icl-rocketry/Ricardo-JollyRoger/Hardware/Ricardo-JollyRoger.kicad_pcb

## KiCad design Hardware/Ricardo-JollyRoger.kicad_pcb (2025-02-01)

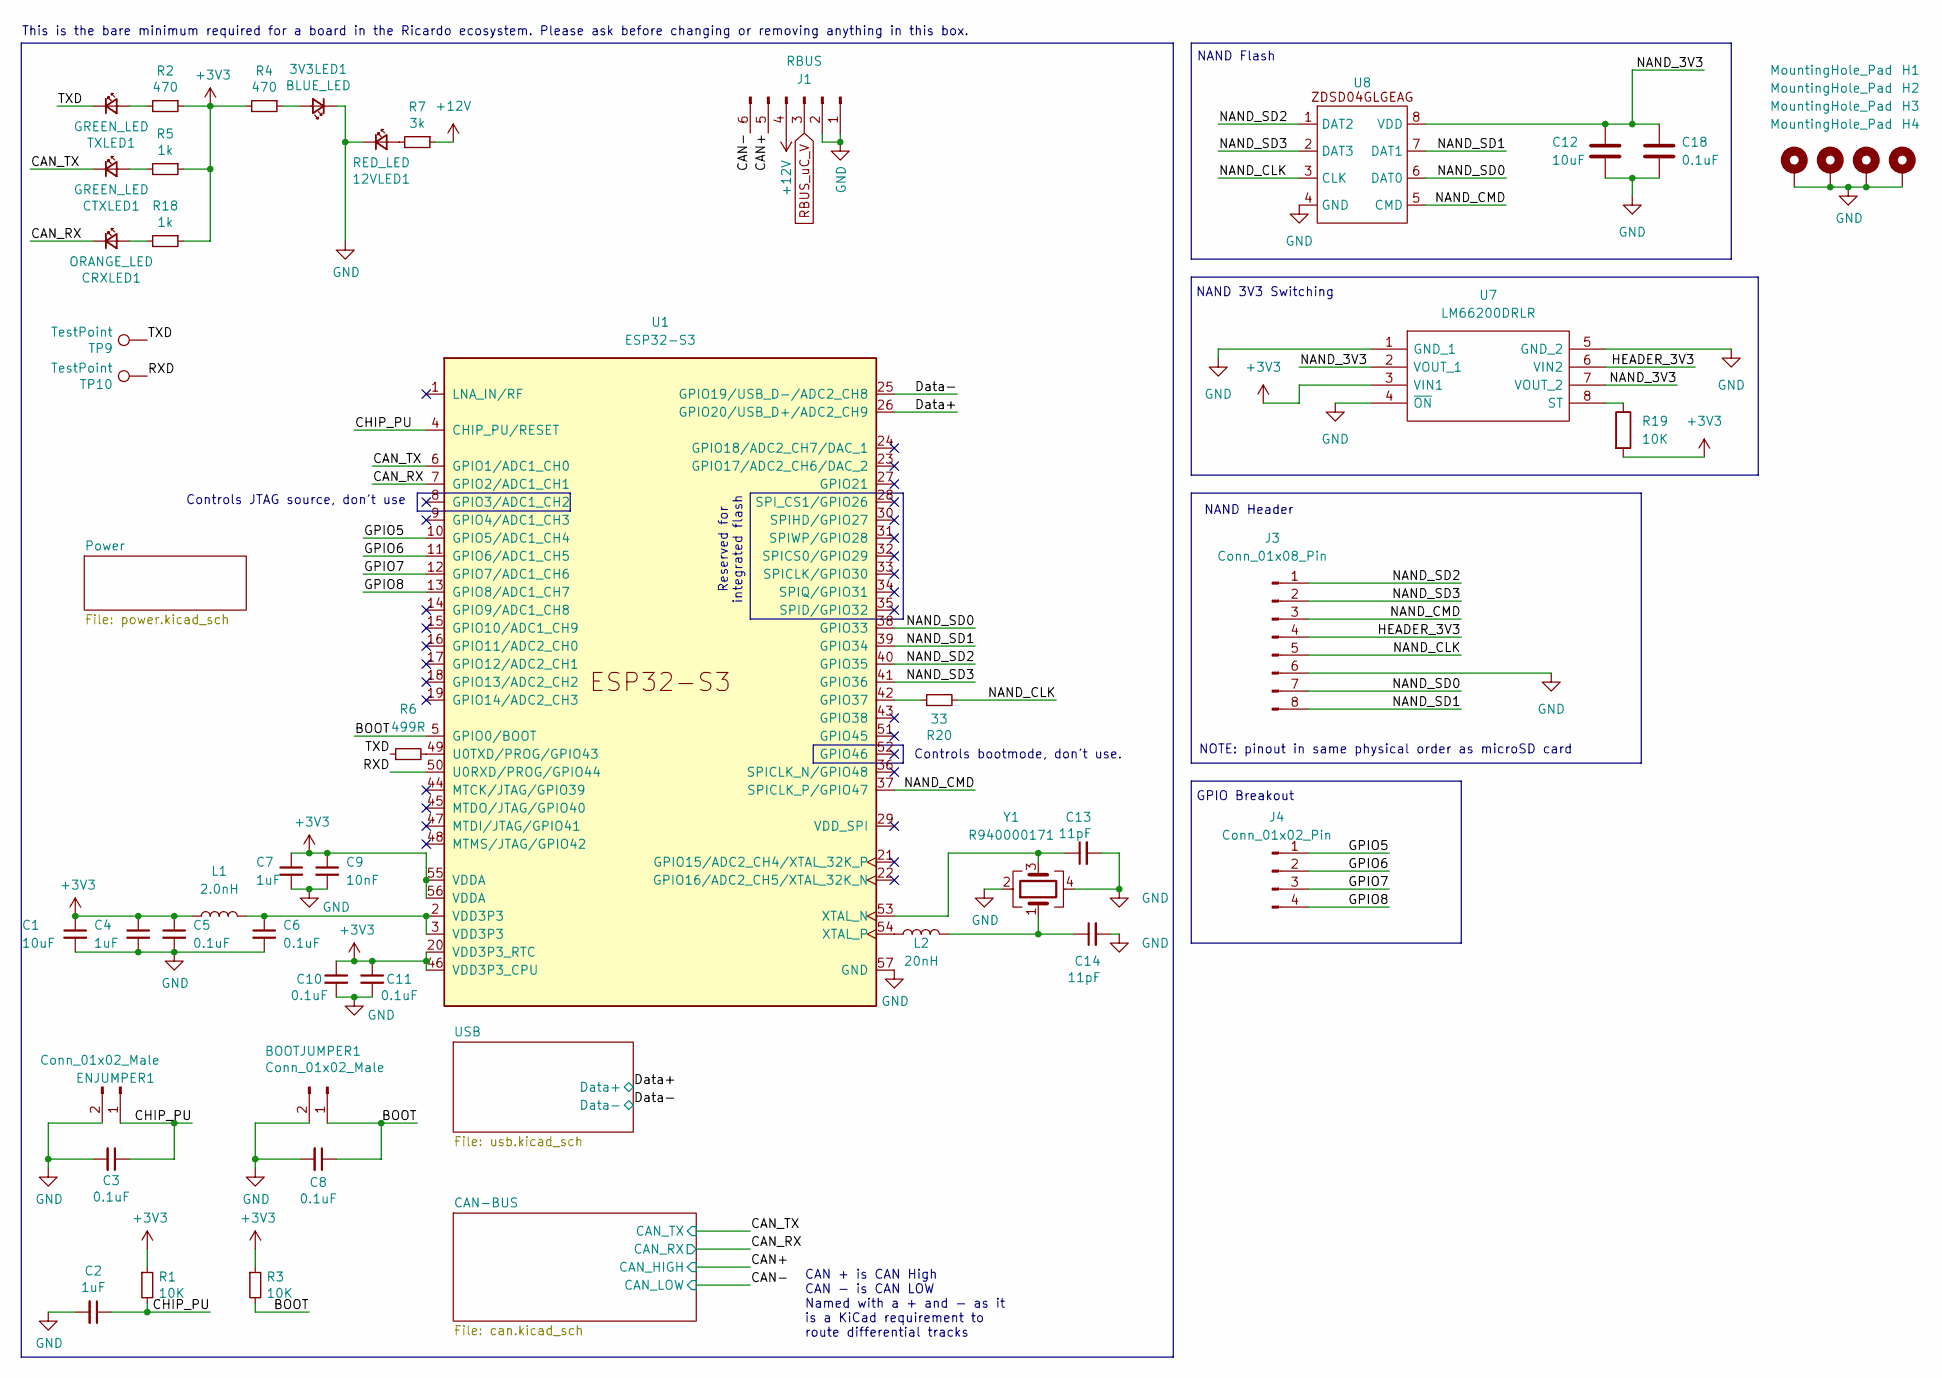
[picture p1: schematic Ricardo-JollyRoger.kicad_sch]

Parts:
3V3LED1: BLUE_LED; LED_0402_1005Metric
12VLED1: RED_LED; LED_0402_1005Metric
BOOTJUMPER1: Conn_01x02_Male; PinHeader_1x02_P2.54mm_Vertical
C1, C12: 10uF; C_0402_1005Metric
C2, C4, C7: 1uF; C_0402_1005Metric
C3, C5, C6, C8, C10, C11, C18: 0.1uF; C_0402_1005Metric
C9: 10nF; C_0402_1005Metric
C13, C14: 11pF; C_0402_1005Metric
CRXLED1: ORANGE_LED; LED_0402_1005Metric
CTXLED1: GREEN_LED; LED_0402_1005Metric
ENJUMPER1: Conn_01x02_Male; PinHeader_1x02_P2.54mm_Vertical
H1, H2, H3, H4: MountingHole_Pad; MountingHole_3.2mm_M3_DIN965_Pad
J1: RBUS; Molex_Mini-Fit_Jr_5566-06A_2x03_P4.20mm_Vertical
J3: Conn_01x08_Pin; Molex_Pico-Clasp_202396-0807_1x08-1MP_P1.00mm_Horizontal
J4: Conn_01x02_Pin; Molex_Pico-Clasp_202396-0407_1x04-1MP_P1.00mm_Horizontal
L1: 2.0nH; L_0402_1005Metric
L2: 20nH; L_0402_1005Metric
R1, R3, R19: 10K; R_0402_1005Metric
R2, R4: 470; R_0402_1005Metric
R5, R18: 1k; R_0402_1005Metric
R6: 499R; R_0402_1005Metric
R7: 3k; R_0402_1005Metric
R20: 33; R_0402_1005Metric
TP9, TP10: TestPoint; TestPoint_Pad_D1.0mm
TXLED1: GREEN_LED; LED_0402_1005Metric
U1: ESP32-S3; QFN40P700X700X90-57N
U7: LM66200DRLR; SOTFL50P160X60-8N; Manufacturer_Part_Number LM66200DRLR; Mouser Part Number 595-LM66200DRLR
U8: LGA-8_8x6mm_P1.27mm
Y1: R940000171; Crystal_SMD_2016-4Pin_2.0x1.6mm

Connections:
+3V3: C1.1, C4.1, C5.1, C7.1, C9.1, C10.1, C11.1, L1.1, R1.1, R2.1, R3.1, R4.2, R5.1, R18.1, R19.2, U1.20 (VDD3P3_RTC), U1.46 (VDD3P3_CPU), U1.55 (VDDA), U1.56 (VDDA), U7.3 (VIN1); also elsewhere on the board
+12V: J1.4, R7.1
/BOOT: BOOTJUMPER1.1, C8.1, R3.2, U1.5 (GPIO0/BOOT)
/CAN+: J1.5; also elsewhere on the board
/CAN-: J1.6; also elsewhere on the board
/CAN_RX: CRXLED1.1 (K), U1.7 (GPIO2/ADC1_CH1); also elsewhere on the board
/CAN_TX: CTXLED1.1 (K), U1.6 (GPIO1/ADC1_CH0); also elsewhere on the board
/CHIP_PU: C2.1, C3.1, ENJUMPER1.1, R1.2, U1.4 (CHIP_PU/RESET)
/Data+: U1.26 (GPIO20/USB_D+/ADC2_CH9); also elsewhere on the board
/Data-: U1.25 (GPIO19/USB_D-/ADC2_CH8); also elsewhere on the board
/GPIO5: J4.1, U1.10 (GPIO5/ADC1_CH4)
/GPIO6: J4.2, U1.11 (GPIO6/ADC1_CH5)
/GPIO7: J4.3, U1.12 (GPIO7/ADC1_CH6)
/GPIO8: J4.4, U1.13 (GPIO8/ADC1_CH7)
/HEADER_3V3: J3.4, U7.6 (VIN2)
/NAND_3V3: C12.1, C18.1, U7.2 (VOUT_1), U7.7 (VOUT_2), U8.8 (VDD)
/NAND_CLK: J3.5, R20.2, U8.3 (CLK)
/NAND_CMD: J3.3, U1.37 (SPICLK_P/GPIO47), U8.5 (CMD)
/NAND_SD0: J3.7, U1.38 (GPIO33), U8.6 (DAT0)
/NAND_SD1: J3.8, U1.39 (GPIO34), U8.7 (DAT1)
/NAND_SD2: J3.1, U1.40 (GPIO35), U8.1 (DAT2)
/NAND_SD3: J3.2, U1.41 (GPIO36), U8.2 (DAT3)
/RXD: TP10.1, U1.50 (U0RXD/PROG/GPIO44)
/TXD: R6.1, TP9.1, TXLED1.1 (K)
GND: 3V3LED1.1 (K), 12VLED1.1 (K), BOOTJUMPER1.2, C1.2, C2.2, C3.2, C4.2, C5.2, C6.2, C7.2, C8.2, C9.2, C10.2, C11.2, C12.2, C13.2, C14.2, C18.2, ENJUMPER1.2, H1.1, H2.1, H3.1, H4.1, J1.1, J1.2, J3.6, U1.57 (GND), U7.1 (GND_1), U7.4 (~ON), U7.5 (GND_2), U8.4 (GND), Y1.2, Y1.4; also elsewhere on the board
unnamed: 3V3LED1.2 (A), R4.1
unnamed: 12VLED1.2 (A), R7.2
unnamed: C6.1, L1.2, U1.2 (VDD3P3), U1.3 (VDD3P3)
unnamed: C14.1, L2.2, Y1.1
unnamed: CRXLED1.2 (A), R18.2
unnamed: CTXLED1.2 (A), R5.2
unnamed: R2.2, TXLED1.2 (A)
unnamed: R20.1, U1.42 (GPIO37)
unnamed: R6.2, U1.49 (U0TXD/PROG/GPIO43)
unnamed: C13.1, U1.53 (XTAL_N), Y1.3
unnamed: L2.1, U1.54 (XTAL_P)
unnamed: R19.1, U7.8 (ST)
RBUS_uC_V: J1.3; also elsewhere on the board

Notes on the sheet:
Controls bootmode, don't use.
NAND Flash
This is the bare minimum required for a board in the Ricardo ecosystem. Please ask before changing or removing anything in this box.
CAN + is CAN High CAN - is CAN LOW Named with a + and - as it is a KiCad requirement to route differential tracks
NOTE: pinout in same physical order as microSD card
NAND 3V3 Switching
GPIO Breakout
Controls JTAG source, don't use
Reserved for integrated flash
NAND Header

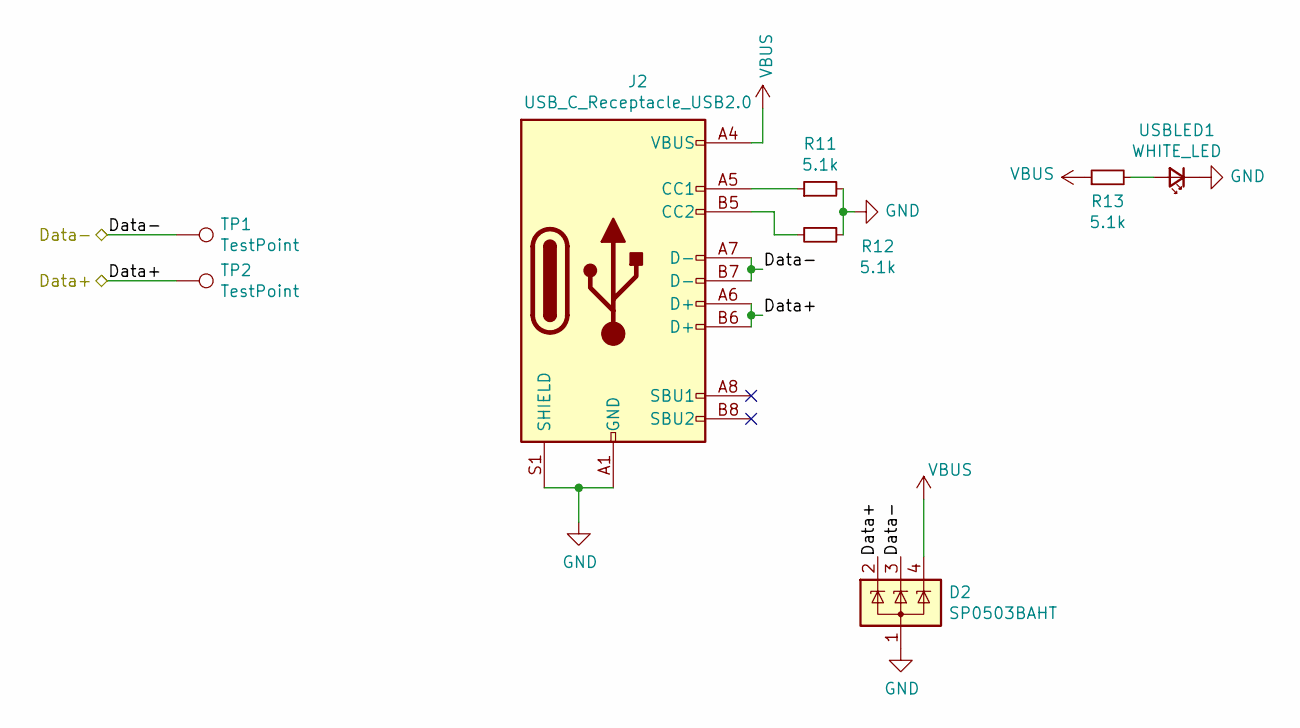
[picture p2: schematic usb.kicad_sch]

Parts:
D2: SP0503BAHT; SOT-143
J2: USB_C_Receptacle_USB2.0; USB_C_Receptacle_Palconn_UTC16-G
R11, R12, R13: 5.1k; R_0402_1005Metric
TP1, TP2: TestPoint; TestPoint_Pad_D1.0mm
USBLED1: WHITE_LED; LED_0402_1005Metric

Connections:
/Data+: D2.2 (K), J2.A6 (D+), J2.B6 (D+), TP2.1; also elsewhere on the board
/Data-: D2.3 (K), J2.A7 (D-), J2.B7 (D-), TP1.1; also elsewhere on the board
GND: D2.1 (A), J2.A1 (GND), J2.A12 (GND), J2.B1 (GND), J2.B12 (GND), J2.S1 (SHIELD), R11.2, R12.1, USBLED1.1 (K); also elsewhere on the board
unnamed: J2.A5 (CC1), R11.1
unnamed: J2.B5 (CC2), R12.2
unnamed: R13.2, USBLED1.2 (A)
VBUS: D2.4 (K), J2.A4 (VBUS), J2.A9 (VBUS), J2.B4 (VBUS), J2.B9 (VBUS), R13.1; also elsewhere on the board

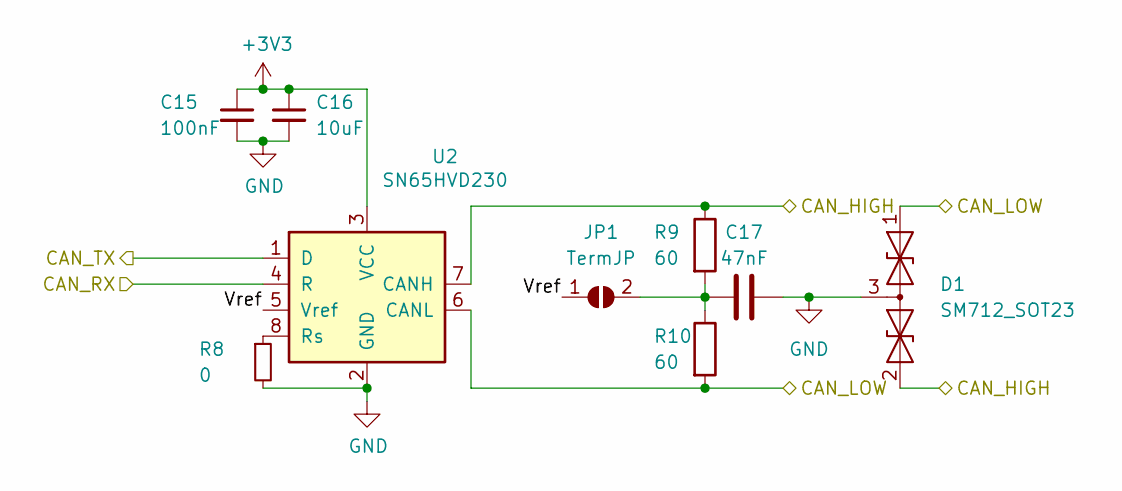
[picture p3: schematic can.kicad_sch]

Parts:
C15: 100nF; C_0402_1005Metric
C16: 10uF; C_0402_1005Metric
C17: 47nF; C_0402_1005Metric
D1: SM712_SOT23; SOT-23
JP1: TermJP; SolderJumper-2_P1.3mm_Open_RoundedPad1.0x1.5mm
R8: 0; R_0402_1005Metric
R9, R10: 60; R_0603_1608Metric
U2: SN65HVD230; SOIC-8_3.9x4.9mm_P1.27mm

Connections:
+3V3: C15.1, C16.1, U2.3 (VCC); also elsewhere on the board
/CAN+: D1.2 (A2), R9.1, U2.7 (CANH); also elsewhere on the board
/CAN-: D1.1 (A1), R10.2, U2.6 (CANL); also elsewhere on the board
/CAN-BUS/Vref: JP1.1 (A), U2.5 (Vref)
/CAN_RX: U2.4 (R); also elsewhere on the board
/CAN_TX: U2.1 (D); also elsewhere on the board
GND: C15.2, C16.2, C17.2, D1.3 (common), R8.2, U2.2 (GND); also elsewhere on the board
unnamed: C17.1, JP1.2 (B), R9.2, R10.1
unnamed: R8.1, U2.8 (Rs)

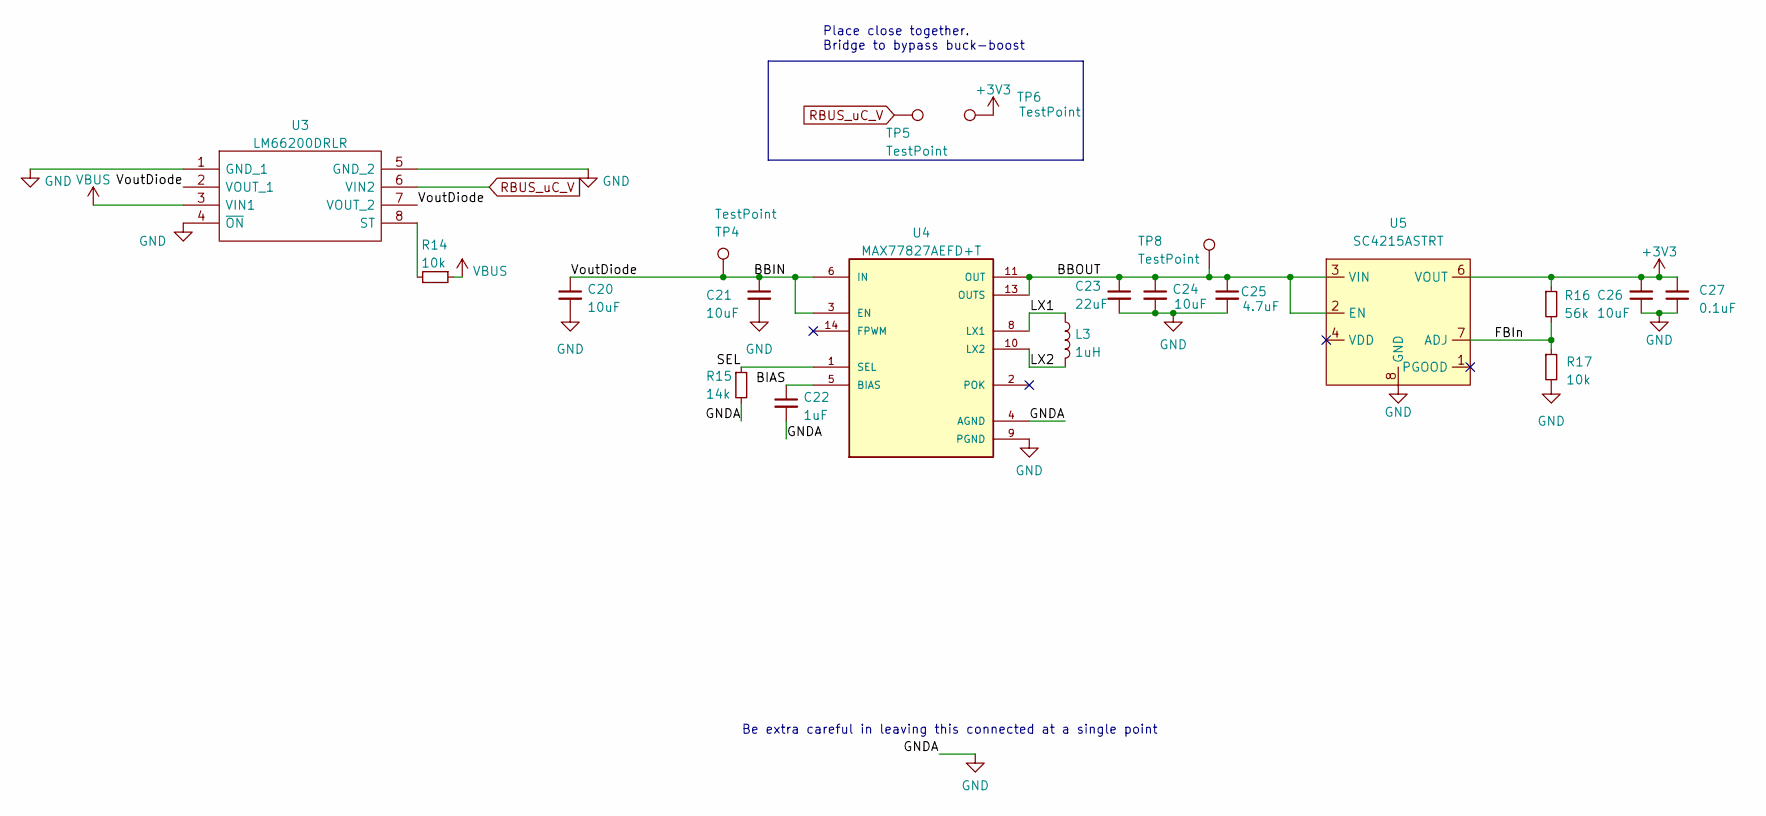
[picture p4: schematic power.kicad_sch]

Parts:
C20, C24, C26: 10uF; C_0402_1005Metric
C21: 10uF; C_0603_1608Metric
C22: 1uF; C_0402_1005Metric
C23: 22uF; C_0603_1608Metric
C25: 4.7uF; C_0402_1005Metric
C27: 0.1uF; C_0402_1005Metric
L3: 1uH; L_0805_2012Metric
R14, R17: 10k; R_0402_1005Metric
R15: 14k; R_0402_1005Metric
R16: 56k; R_0402_1005Metric
TP4, TP5, TP6, TP8: TestPoint; TestPoint_Pad_D1.5mm
U3: LM66200DRLR; SOTFL50P160X60-8N; Manufacturer_Part_Number LM66200DRLR; Mouser Part Number 595-LM66200DRLR
U4: MAX77827AEFD+T; CONV_MAX77827AEFD+T; PARTREV B
U5: SC4215ASTRT; SOIC127P599X175-9N

Connections:
+3V3: C26.2, C27.2, R16.1, TP6.1, U5.6 (VOUT); also elsewhere on the board
/Power/BBIN: C20.1, C21.1, TP4.1, U3.2 (VOUT_1), U3.7 (VOUT_2), U4.3 (EN), U4.6 (IN)
/Power/BBOUT: C23.1, C24.1, C25.1, TP8.1, U4.11 (OUT), U4.13 (OUTS), U5.2 (EN), U5.3 (VIN)
/Power/BIAS: C22.1, U4.5 (BIAS)
/Power/FBIn: R16.2, R17.1, U5.7 (ADJ)
/Power/LX1: L3.1, U4.8 (LX1)
/Power/LX2: L3.2, U4.10 (LX2)
/Power/SEL: R15.1, U4.1 (SEL)
GND: C20.2, C21.2, C22.2, C23.2, C24.2, C25.2, C26.1, C27.1, R15.2, R17.2, U3.1 (GND_1), U3.4 (~ON), U3.5 (GND_2), U4.4 (AGND), U4.9 (PGND), U5.8 (GND), U5.9 (GND); also elsewhere on the board
unnamed: R14.2, U3.8 (ST)
RBUS_uC_V: TP5.1, U3.6 (VIN2); also elsewhere on the board
VBUS: R14.1, U3.3 (VIN1); also elsewhere on the board

Notes on the sheet:
Place close together. Bridge to bypass buck-boost
Be extra careful in leaving this connected at a single point

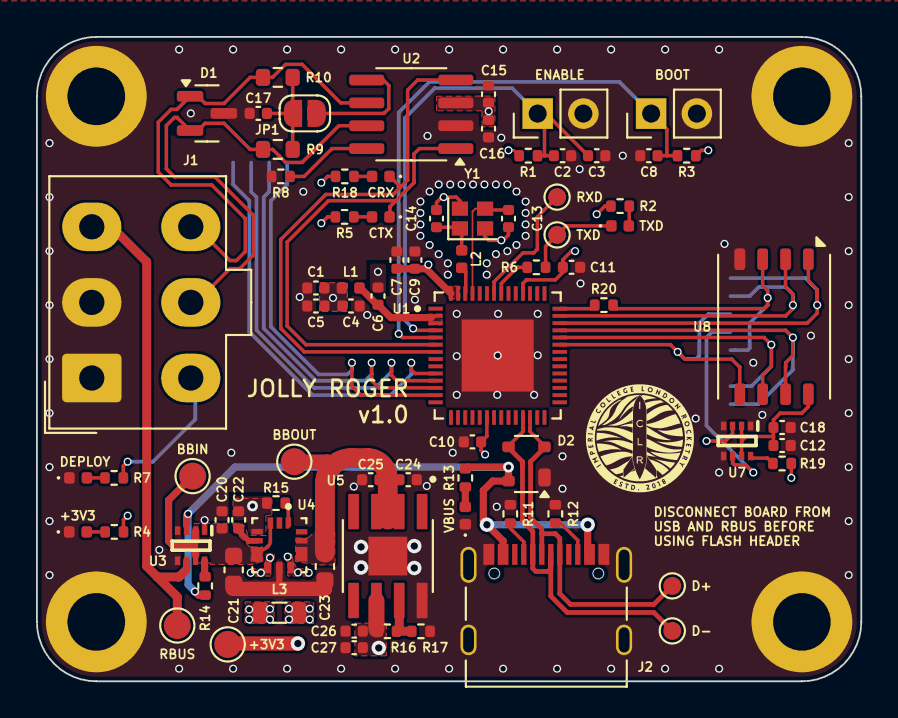
[picture p5: board Ricardo-JollyRoger.kicad_pcb from above]

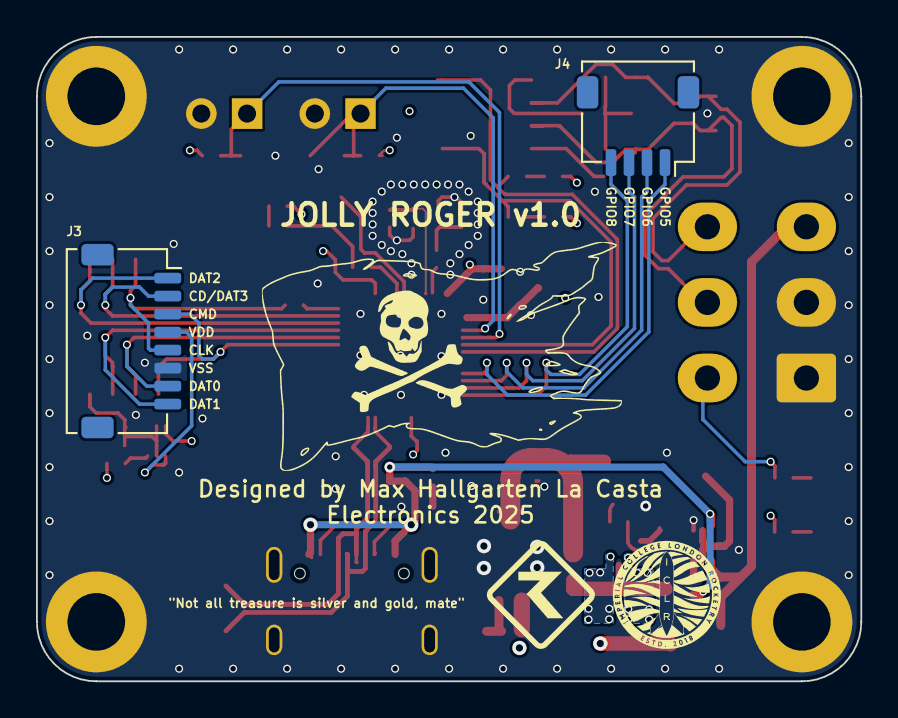
[picture p6: board Ricardo-JollyRoger.kicad_pcb from below]

Board: 4 copper layers, 45.8 x 35.8 mm, 84 parts (3 on the bottom side), 53 nets.
