icl-rocketry/Ricardo-JollyRoger/Firmware/src/system.cpp

#include "system.h"

// Standard imports
#include <cstdlib>
#include <memory>

// Third-party imports
#include <libriccore/riccoresystem.h>
#include <HardwareSerial.h>
#include <Preferences.h>

// Internal imports
#include "config/systemflags_config.h"
#include "config/commands_config.h"
#include "config/pinmap_config.h"
#include "config/services_config.h"
#include "config/general_config.h"
#include "commands/commands.h"
#include "states/idle.h"

// SPI bus configuration
static constexpr int VSPI_BUS_NUM = 0;
static constexpr int HSPI_BUS_NUM = 1;

System::System() : RicCoreSystem(Commands::command_map, Commands::defaultEnabledCommands, Serial),
                   canbus(systemstatus, PinMap::CAN_TX, PinMap::CAN_RX, 3),
                   SDSPI(VSPI_BUS_NUM),
                   primarysd(SDSPI, PinMap::SD_CS, SD_SCK_MHZ(20), true, &systemstatus),
                   timeService(networkmanager, Services::ID::TimeService),
                   prober(networkmanager, Services::ID::ProberService) {}

void System::systemSetup()
{
    // Configure serial interface
    Serial.setRxBufferSize(GeneralConfig::SerialRxSize);
    Serial.begin(GeneralConfig::SerialBaud);

    // Add short delay to boot
    delay(1000);

    // Initialise state machine (idle)
    statemachine.initalize(std::make_unique<Idle>(*this, systemstatus, commandhandler));

    // Configure CAN bus interface
    canbus.setup();

    // Configure network manager
    networkmanager.setAddress(20);
    networkmanager.setNodeType(NODETYPE::HUB);
    networkmanager.setNoRouteAction(NOROUTE_ACTION::BROADCAST, {1, 3});
    networkmanager.addInterface(&canbus);

    // Initialise SD
    setupSD();

    // Initialise loggers
    initializeLoggers();
}

void System::systemUpdate()
{
    // Update telemetry prober
    prober.update();
}

void System::setupSD()
{
    // Enable CS for SD
    pinMode(PinMap::SD_CS, OUTPUT);
    digitalWrite(PinMap::SD_CS, HIGH);

    // Initialise SPI for SD
    SDSPI.begin(PinMap::SD_SCLK, PinMap::SD_MISO, PinMap::SD_MOSI);
    SDSPI.setFrequency(SD_SCK_MHZ(20));
    SDSPI.setBitOrder(MSBFIRST);
    SDSPI.setDataMode(SPI_MODE0);

    // Initialise flash storage
    primarysd.setup();
}

void System::initializeLoggers()
{
    // Check if SD card is mounted
    if (primarysd.getState() != StoreBase::STATE::NOMINAL)
    {
        // Initialise system logger without file pointer
        loggerhandler.retrieve_logger<RicCoreLoggingConfig::LOGGERS::SYS>().initialize(nullptr, networkmanager);

        // Return
        return;
    }

    // Generate unique path for log files
    std::string log_directory_path = primarysd.generateUniquePath(log_path, "");

    // Create new log directory
    primarysd.mkdir(log_directory_path);

    // Open log files
    // NOTE: the packet log requires a larger buffer to reduce the number of dropped writes
    std::unique_ptr<WrappedFile> syslogfile = primarysd.open(log_directory_path + "/syslog.txt", static_cast<FILE_MODE>(O_WRITE | O_CREAT | O_AT_END));
    std::unique_ptr<WrappedFile> packetlogfile = primarysd.open(log_directory_path + "/packets.bin", static_cast<FILE_MODE>(O_WRITE | O_CREAT | O_AT_END), 30);

    // Initialise log files
    loggerhandler.retrieve_logger<RicCoreLoggingConfig::LOGGERS::SYS>().initialize(std::move(syslogfile), networkmanager);
    loggerhandler.retrieve_logger<RicCoreLoggingConfig::LOGGERS::PACKET>().initialize(std::move(packetlogfile), networkmanager, getBootCount());
}

uint16_t System::getBootCount()
{
    // Declare boot count variable
    // NOTE: declared as a static variable here, instead of as a system class variable,
    //       due to instantiation order issues with Arduino Preferences
    static uint16_t bootCount;

    // Declare static initialised flag
    static bool initialised = false;

    // Return system boot count if already initialised
    if (initialised)
    {
        return bootCount;
    }

    // Declare NVS access
    Preferences preferences;

    // Open NVS access
    preferences.begin("JollyRoger", false);

    // Get boot count (default to zero)
    bootCount = preferences.getUShort("bootCount");

    // Increment boot count
    bootCount++;

    // Update stored boot count
    preferences.putUShort("bootCount", bootCount);

    // Close NVS access
    preferences.end();

    // Set initialised
    initialised = true;

    // Return boot count
    return bootCount;
}
