icl-rocketry/Ricardo-JollyRoger/(commit log)

2025-01-07 Ricardo-BlackBox
    Ricardo-BlackBox
    PushingSecondSchematic
    push3schematicandpcb
    4th
    NewESP32RicardoBlackBox
    AsOf13/12/2022
    AsOf31/01/2023
    Schematic should be done, PCB beginning to be done
    AsOf12/04/2023
    RicardoBlackBox03_06_2023
    03/06/2023RicardoBlackBoxAfterICLRMeeting
    13:31
    10_06_2023BlackBox
    All files for Black Box needed are in this
    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
    [NewRicardBlackBox.kicad_pcb, NewRicardoBlackBox.kicad_sch, Ricardo-BlackBox.kicad_pcb, Ricardo-BlackBox.kicad_sch, Ricardo-BlackBoxNEW.kicad_pcb, Ricardo-BlackBoxNEW.kicad_sch, Ricardo-BlackBoxNEWFinal.kicad_pcb, Ricardo-BlackBoxNEWFinal.kicad_sch]
2025-01-07 Purge firmware
    [ricpart.csv]
2025-01-07 Basic heartbeat implementation
    [ricpart.csv]
2025-01-07 System time getter and setter in millis
2025-01-07 Switch to SdFat fork
2025-01-07 Initial hardware update
    [NewRicardBlackBox.kicad_pcb, NewRicardoBlackBox.kicad_sch, Ricardo-BlackBox.kicad_pcb, Ricardo-BlackBox.kicad_sch, Ricardo-BlackBoxNEW.kicad_pcb, Ricardo-BlackBoxNEW.kicad_sch, Ricardo-BlackBoxNEWFinal.kicad_pcb, Ricardo-BlackBoxNEWFinal.kicad_sch]
2025-01-07 Moved decoupling capacitors
    [Ricardo-BlackBox.kicad_pcb, Ricardo-BlackBox.kicad_sch]
2025-01-07 Moved USB test pads
    [Ricardo-BlackBox.kicad_pcb]
2025-01-07 Removed data line switching and rearranged
    [Ricardo-BlackBox.kicad_pcb, Ricardo-BlackBox.kicad_sch]
2025-01-07 Fixed zone priorities
    [Ricardo-BlackBox.kicad_pcb]
2025-01-07 Update crystal exclusion zone and grounding
    [Ricardo-BlackBox.kicad_pcb]
2025-01-07 Changed NAND flash to ZDSD04GLGEAG
    [Ricardo-BlackBox.kicad_pcb, Ricardo-BlackBox.kicad_sch]
2025-01-07 Switched to PicoBlade connector
    [Ricardo-BlackBox.kicad_pcb, Ricardo-BlackBox.kicad_sch]
2025-01-07 Changed to PicoClasp connector
    [Ricardo-BlackBox.kicad_pcb, Ricardo-BlackBox.kicad_sch]
2025-01-07 Updated directory structure
    [Ricardo-BlackBox.kicad_pcb, Ricardo-BlackBox.kicad_sch, can.kicad_sch, power.kicad_sch, usb.kicad_sch]
2025-01-07 Update name position
    [Ricardo-BlackBox.kicad_pcb]
2025-01-07 Moved CAN RX/TX lines
    [Ricardo-BlackBox.kicad_pcb]
2025-01-07 Added additional vias
    [Ricardo-BlackBox.kicad_pcb]
2025-01-07 Move TXD/RXD pads
    [Ricardo-BlackBox.kicad_pcb]
2025-01-07 Move NAND flash chip
    [Ricardo-BlackBox.kicad_pcb]
2025-01-07 Ensure VBUS connections after ESD protection
    [Ricardo-BlackBox.kicad_pcb]
2025-01-07 Update silkscreen labels for LEDs and pads
    [Ricardo-BlackBox.kicad_pcb]
2025-01-07 Update zone fill for CAN chip
    [Ricardo-BlackBox.kicad_pcb]
2025-01-07 Update length matching
    [Ricardo-BlackBox.kicad_pcb]
2025-01-07 Updated buckboost silkscreen labels
    [Ricardo-BlackBox.kicad_pcb]
2025-01-07 Increased VBUS trace widths and rerouted
    [Ricardo-BlackBox.kicad_pcb]
2025-01-07 Updated RBUS trace
    [Ricardo-BlackBox.kicad_pcb]
2025-01-07 Updated USB data line trace widths
    [Ricardo-BlackBox.kicad_pcb]
2025-01-07 Reduced XO trace width
    [Ricardo-BlackBox.kicad_pcb]
2025-01-07 Rearranging ESP32 CLC
    [Ricardo-BlackBox.kicad_pcb]
2025-01-07 Fixed fill zones
    [Ricardo-BlackBox.kicad_pcb]
2025-01-07 Moved NAND flash chip and added debounce resistor
    [Ricardo-BlackBox.kicad_pcb, Ricardo-BlackBox.kicad_sch]
2025-01-07 Rearranged NAND 3V3 switching and fixed buck-boost overlaps
    [Ricardo-BlackBox.kicad_pcb]
2025-01-07 Hoisted the colours
    [Ricardo-BlackBox.kicad_pcb]
2025-01-07 Updated KiCad filenames
    [Ricardo-JollyRoger.kicad_pcb, Ricardo-JollyRoger.kicad_sch]
2025-01-20 Tweaked trace
    [Ricardo-JollyRoger.kicad_pcb]
2025-01-20 Added additional GND vias
    [Ricardo-JollyRoger.kicad_pcb]
2025-01-20 Made deployment LED label generic
    [Ricardo-JollyRoger.kicad_pcb]
2025-01-20 Moved C11 closer to ESP32
    [Ricardo-JollyRoger.kicad_pcb]
2025-01-20 Re-routed HEADER_3V3 trace and added via to improve the ground path between the NAND chip and the connector
    [Ricardo-JollyRoger.kicad_pcb]
2025-01-20 Added additional ground vias near the CAN chip
    [Ricardo-JollyRoger.kicad_pcb]
2025-01-20 Moved NAND power switching to reduce distance of decoupling capacitors
    [Ricardo-JollyRoger.kicad_pcb]
2025-01-20 Added quote
    [Ricardo-JollyRoger.kicad_pcb]
2025-01-25 Updated footprints
    [Ricardo-JollyRoger.kicad_pcb, Ricardo-JollyRoger.kicad_sch, can.kicad_sch, usb.kicad_sch]
2025-01-25 Updated exclusion around XO
    [Ricardo-JollyRoger.kicad_pcb]
2025-01-25 Increase board size
    [Ricardo-JollyRoger.kicad_pcb]
2025-01-25 Added edge vias
    [Ricardo-JollyRoger.kicad_pcb]
2025-01-25 Updated NAND traces
    [Ricardo-JollyRoger.kicad_pcb]
2025-01-25 Added standalone labels for named components
    [Ricardo-JollyRoger.kicad_pcb]
2025-01-25 Updated NAND termination resistor
    [Ricardo-JollyRoger.kicad_pcb, Ricardo-JollyRoger.kicad_sch]
2025-01-25 Marked unused ESP32 pins
    [Ricardo-JollyRoger.kicad_pcb, Ricardo-JollyRoger.kicad_sch]
2025-01-26 Added labels for NAND pinout
    [Ricardo-JollyRoger.kicad_pcb]
2025-01-26 Reduce edge via size
    [Ricardo-JollyRoger.kicad_pcb]
2025-01-27 Added GPIO breakout
    [Ricardo-JollyRoger.kicad_pcb, Ricardo-JollyRoger.kicad_sch]
2025-01-28 Rearranged NAND
    [Ricardo-JollyRoger.kicad_pcb]
2025-01-28 Add warning message
    [Ricardo-JollyRoger.kicad_pcb]
2025-02-01 Upgrade GPIO breakout to four pins
    [Ricardo-JollyRoger.kicad_pcb, Ricardo-JollyRoger.kicad_sch]
2025-02-19 Replace epoch time with boot count in logged packets
    [system.cpp]
2025-02-20 Initial prober implementation
2025-02-25 Initial migration
    [ricparts3.csv]
